MinhNhut223/Autonomous-Drone-With-Pathfinding-Capabilities/Drawing/Xuất bản vẽ/Ban_ve_phan_ra.pdf

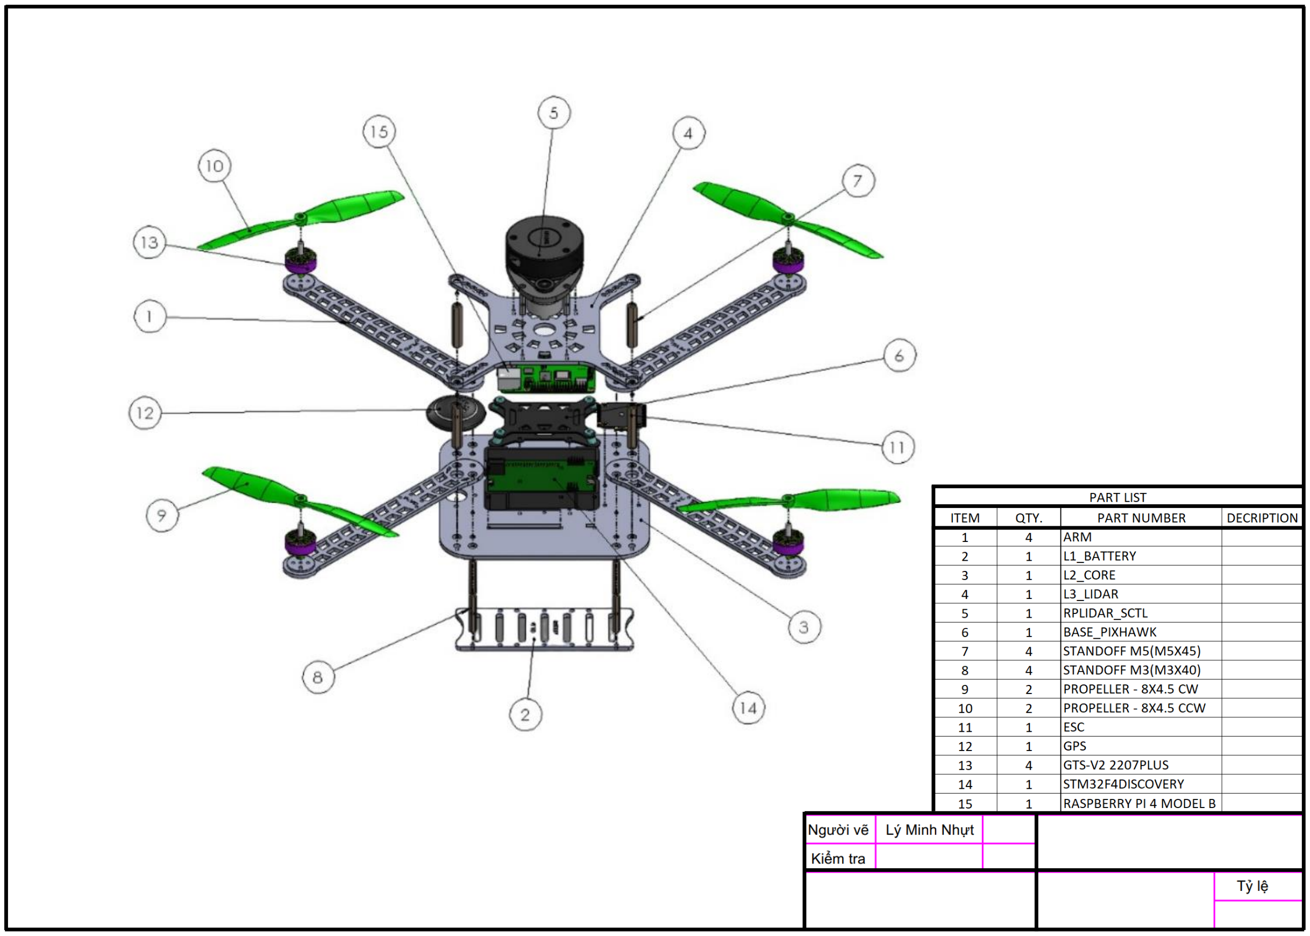
[picture p62: page 1]
