MinhNhut223/Autonomous-Drone-With-Pathfinding-Capabilities/(list of files, cad)

Other CAD files:
File Drawing/File Drawing/Arm_Banve.SLDDRW
File Drawing/File Drawing/L1Battery_Banve.SLDDRW
File Drawing/File Drawing/L2Core_Banve.SLDDRW
File Drawing/File Drawing/L3Lidar_Banve.SLDDRW
