MinhNhut223/Autonomous-Drone-With-Pathfinding-Capabilities/Drawing/Xuất bản vẽ/Arm_Banve.pdf

# SECTION B-B 21.00

A

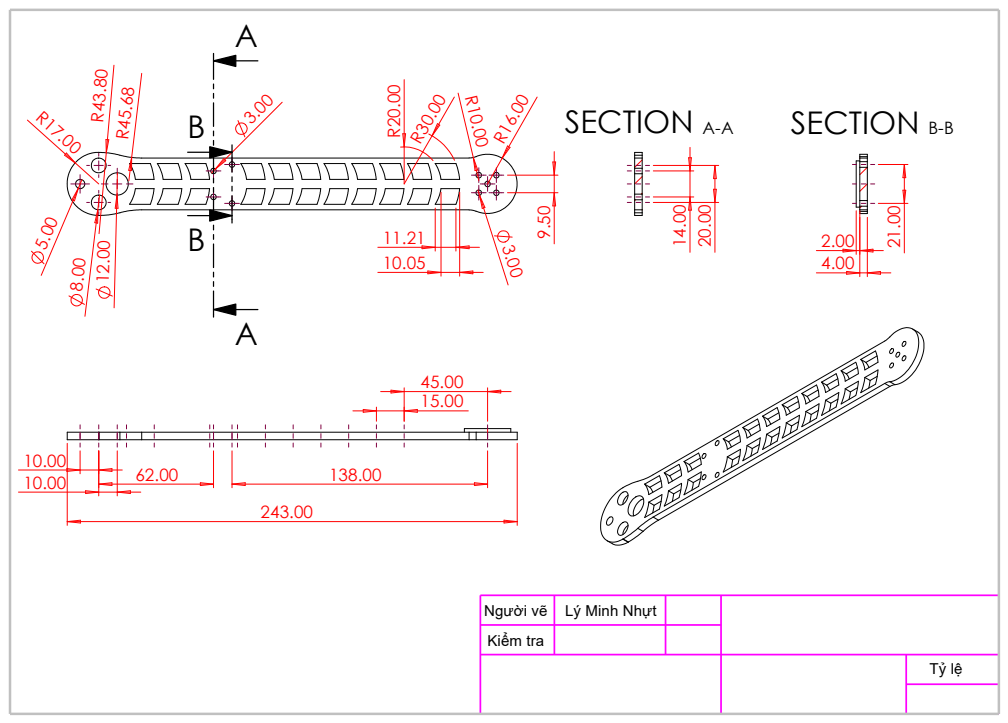
[picture p63: page 1]
SECTION A-A 14.00

Người vẽ | Lý Minh Nhựt
Kiểm tra
