MinhNhut223/Autonomous-Drone-With-Pathfinding-Capabilities/Drawing/Xuất bản vẽ/L1Battery_Banve.pdf

B

# SECTION B-B

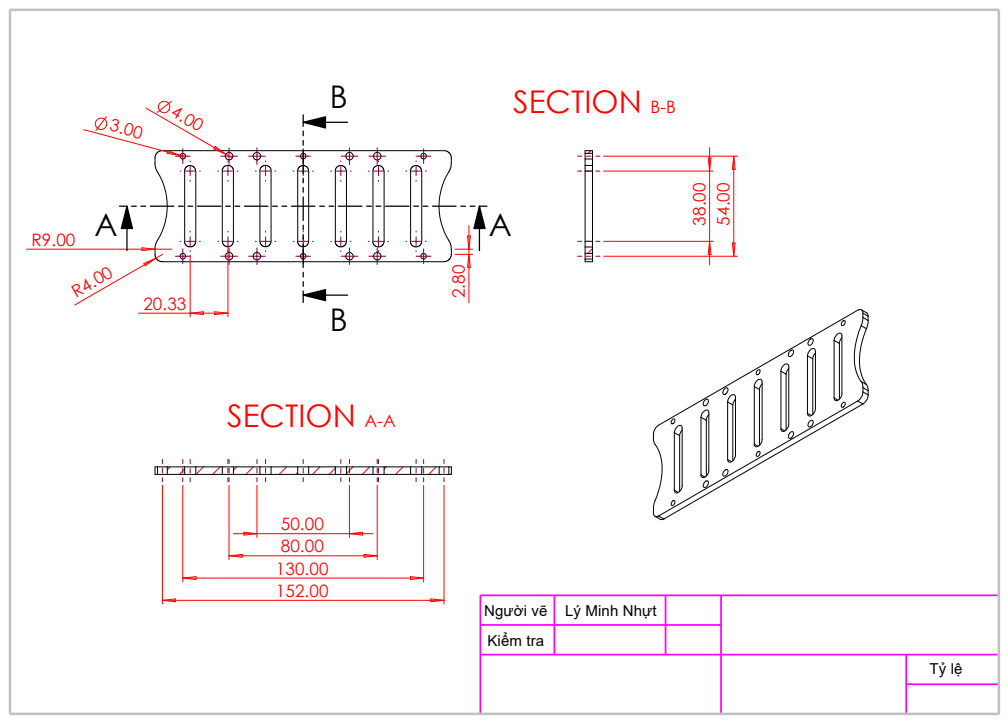
[picture p64: page 1]
SECTION A-A

Người vẽ | Lý Minh Nhựt
Kiểm tra
