MinhNhut223/Autonomous-Drone-With-Pathfinding-Capabilities/Drawing/Xuất bản vẽ/L2Core_Banve.pdf

B

# SECTION B-B

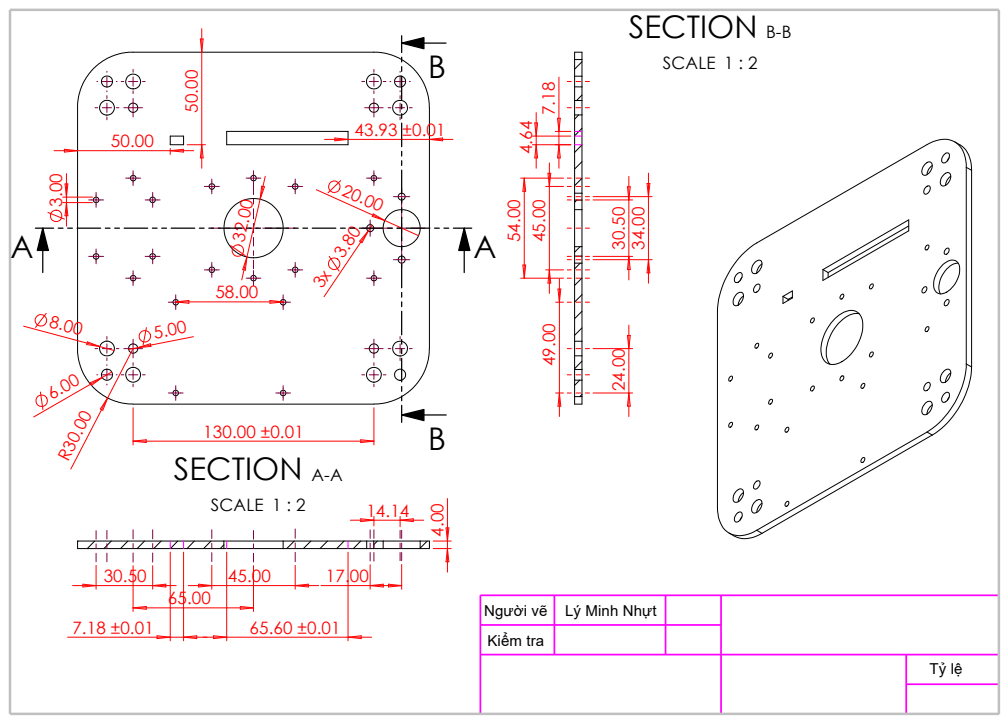
[picture p65: page 1]
SECTION A-A; SCALE 1 : 2

Người vẽ | Lý Minh Nhựt
Kiểm tra
