MinhNhut223/Autonomous-Drone-With-Pathfinding-Capabilities/Drawing/Xuất bản vẽ/L3Lidar_Banve.pdf

BB

# SECTION B-B

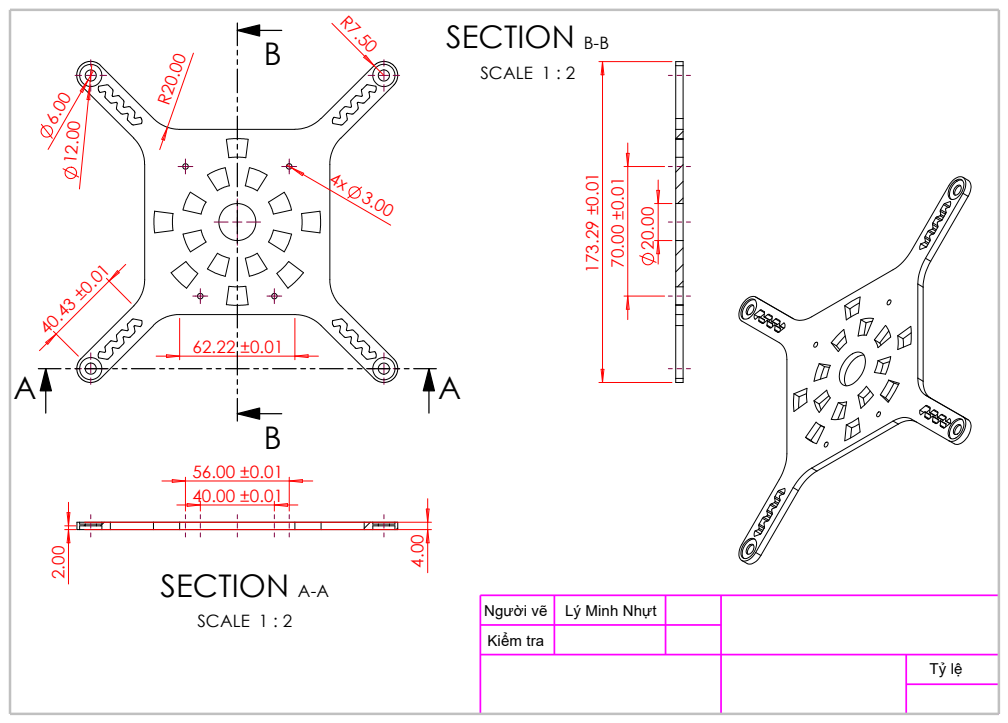
[picture p66: page 1]
SCALE 1 : 2; SECTION A-A

Người vẽ | Lý Minh Nhựt
Kiểm tra
